xsumedh-st/HapticTalk/app/haptictalk/README.md

void setup() {
  Serial.begin(9600);
}

void loop() {
  Serial.println("Hello from UNO Q");
  delay(1000);
}
